lhr-solar/VCAT-BlackBody/hardware/BlackBodyBoard.csv

Reference | Qty | P/N | Value | DNP | Exclude from BOM | Exclude from Board | Exclude from Simulation | Exclude from Position Files | Footprint | Datasheet
C1 | 1 | 0603N270F500CT | 26p |  |  |  |  | ${EXCLUDE_FROM_POS_FILES} | Capacitor_SMD:C_0603_1608Metric_Pad1.08x0.95mm_HandSolder
C2 | 1 | 0603N270F500CT | 26p |  |  |  |  | ${EXCLUDE_FROM_POS_FILES} | Capacitor_SMD:C_0603_1608Metric_Pad1.08x0.95mm_HandSolder
C3 | 1 | MLASH168SB7104KTNA01 | 0.1u |  |  |  |  | ${EXCLUDE_FROM_POS_FILES} | Capacitor_SMD:C_0603_1608Metric_Pad1.08x0.95mm_HandSolder
C4 | 1 | GRM21BR61H106KE43K | 10u |  |  |  |  | ${EXCLUDE_FROM_POS_FILES} | Capacitor_SMD:C_0805_2012Metric
C5 | 1 | MLASH168SB7104KTNA01 | 0.1u |  |  |  |  | ${EXCLUDE_FROM_POS_FILES} | Capacitor_SMD:C_0603_1608Metric_Pad1.08x0.95mm_HandSolder
C6 | 1 | MLASH168SB7104KTNA01 | 0.1u |  |  |  |  | ${EXCLUDE_FROM_POS_FILES} | Capacitor_SMD:C_0603_1608Metric_Pad1.08x0.95mm_HandSolder
C7 | 1 | MLASH168SB7104KTNA01 | 0.1u |  |  |  |  | ${EXCLUDE_FROM_POS_FILES} | Capacitor_SMD:C_0603_1608Metric_Pad1.08x0.95mm_HandSolder
C8 | 1 | MLASH168SB7104KTNA01 | 0.1u |  |  |  |  | ${EXCLUDE_FROM_POS_FILES} | Capacitor_SMD:C_0603_1608Metric_Pad1.08x0.95mm_HandSolder
C9 | 1 | MLASU168SB5105KTNA01 | 1u |  |  |  |  | ${EXCLUDE_FROM_POS_FILES} | Capacitor_SMD:C_0603_1608Metric_Pad1.08x0.95mm_HandSolder
C10 | 1 | MLASH168SB7104KTNA01 | 0.1u |  |  |  |  | ${EXCLUDE_FROM_POS_FILES} | Capacitor_SMD:C_0603_1608Metric_Pad1.08x0.95mm_HandSolder
C11 | 1 | MLASU168SB5105KTNA01 | 1u |  |  |  |  | ${EXCLUDE_FROM_POS_FILES} | Capacitor_SMD:C_0603_1608Metric_Pad1.08x0.95mm_HandSolder
C12 | 1 | MLASH168SB7104KTNA01 | 0.1u |  |  |  |  | ${EXCLUDE_FROM_POS_FILES} | Capacitor_SMD:C_0603_1608Metric_Pad1.08x0.95mm_HandSolder
C13 | 1 | MLASH168SB7104KTNA01 | 0.1u |  |  |  |  | ${EXCLUDE_FROM_POS_FILES} | Capacitor_SMD:C_0603_1608Metric_Pad1.08x0.95mm_HandSolder
C14 | 1 | MLASH168SB7104KTNA01 | 0.1u |  |  |  |  | ${EXCLUDE_FROM_POS_FILES} | Capacitor_SMD:C_0603_1608Metric_Pad1.08x0.95mm_HandSolder
C15 | 1 | MLASH168SB7104KTNA01 | 100n |  |  |  |  | ${EXCLUDE_FROM_POS_FILES} | Capacitor_SMD:C_0603_1608Metric_Pad1.08x0.95mm_HandSolder
C16 | 1 | GRM21BR61H106KE43K | 10u |  |  |  |  | ${EXCLUDE_FROM_POS_FILES} | Capacitor_SMD:C_0805_2012Metric_Pad1.18x1.45mm_HandSolder
C17 | 1 | MLASH168SB7104KTNA01 | 0.1u |  |  |  |  | ${EXCLUDE_FROM_POS_FILES} | Capacitor_SMD:C_0603_1608Metric_Pad1.08x0.95mm_HandSolder
C18 | 1 | MLASH168SB7104KTNA01 | 0.1u |  |  |  |  | ${EXCLUDE_FROM_POS_FILES} | Capacitor_SMD:C_0603_1608Metric_Pad1.08x0.95mm_HandSolder
C19 | 1 | MLASH168SB7104KTNA01 | 0.1u |  |  |  |  | ${EXCLUDE_FROM_POS_FILES} | Capacitor_SMD:C_0603_1608Metric_Pad1.08x0.95mm_HandSolder
C23 | 1 | CL10B104KB8NNNC | 100n |  |  |  |  | ${EXCLUDE_FROM_POS_FILES} | Capacitor_SMD:C_0603_1608Metric_Pad1.08x0.95mm_HandSolder | ~
C24 | 1 | TMK212BBJ106MGHT | 10u |  |  |  |  | ${EXCLUDE_FROM_POS_FILES} | Capacitor_SMD:C_0805_2012Metric
C25 | 1 | CC0603KRX7R9BB105 | 1u |  |  |  |  | ${EXCLUDE_FROM_POS_FILES} | Capacitor_SMD:C_0603_1608Metric_Pad1.08x0.95mm_HandSolder | ~
C26 | 1 | CL10B104KB8NNNC | 100n |  |  |  |  | ${EXCLUDE_FROM_POS_FILES} | Capacitor_SMD:C_0603_1608Metric_Pad1.08x0.95mm_HandSolder | ~
C27 | 1 | CL10B104KB8NNNC | 100n |  |  |  |  | ${EXCLUDE_FROM_POS_FILES} | Capacitor_SMD:C_0603_1608Metric_Pad1.08x0.95mm_HandSolder | ~
C28 | 1 | CC0603KRX7R9BB103 | 10n |  |  |  |  | ${EXCLUDE_FROM_POS_FILES} | Capacitor_SMD:C_0603_1608Metric_Pad1.08x0.95mm_HandSolder | ~
C29 | 1 | CC0603KRX7R9BB103 | 10n |  |  |  |  | ${EXCLUDE_FROM_POS_FILES} | Capacitor_SMD:C_0603_1608Metric_Pad1.08x0.95mm_HandSolder | ~
C30 | 1 | CC0603KRX7R9BB103 | 10n |  |  |  |  | ${EXCLUDE_FROM_POS_FILES} | Capacitor_SMD:C_0603_1608Metric_Pad1.08x0.95mm_HandSolder | ~
C31 | 1 | CC0603KRX7R9BB103 | 10n |  |  |  |  | ${EXCLUDE_FROM_POS_FILES} | Capacitor_SMD:C_0603_1608Metric_Pad1.08x0.95mm_HandSolder | ~
C40 | 1 | 08055D475KAT4A | 4.7u |  |  |  |  | ${EXCLUDE_FROM_POS_FILES} | Capacitor_SMD:C_0805_2012Metric_Pad1.18x1.45mm_HandSolder
C41 | 1 | MLASH168SB7104KTNA01 | 100n |  |  |  |  | ${EXCLUDE_FROM_POS_FILES} | Capacitor_SMD:C_0603_1608Metric_Pad1.08x0.95mm_HandSolder
C42 | 1 | MLASH168SB7104KTNA01 | 100n |  |  |  |  | ${EXCLUDE_FROM_POS_FILES} | Capacitor_SMD:C_0603_1608Metric
C43 | 1 | GMK325BJ226MM-P | 22u |  |  |  |  | ${EXCLUDE_FROM_POS_FILES} | Capacitor_SMD:C_1210_3225Metric_Pad1.33x2.70mm_HandSolder
C44 | 1 | GMK325BJ226MM-P | 22u |  |  |  |  | ${EXCLUDE_FROM_POS_FILES} | Capacitor_SMD:C_1210_3225Metric_Pad1.33x2.70mm_HandSolder
C45 | 1 | C2012X5R1H335K125AB | 3.3u |  |  |  |  | ${EXCLUDE_FROM_POS_FILES} | Capacitor_SMD:C_0805_2012Metric_Pad1.18x1.45mm_HandSolder
C46 | 1 | GRM21BR61H106KE43K | 10u |  |  |  |  | ${EXCLUDE_FROM_POS_FILES} | Capacitor_SMD:C_0805_2012Metric_Pad1.18x1.45mm_HandSolder
C47 | 1 | GRM21BR61H106KE43K | 10u |  |  |  |  | ${EXCLUDE_FROM_POS_FILES} | Capacitor_SMD:C_0805_2012Metric_Pad1.18x1.45mm_HandSolder
C48 | 1 | CL10B104KB8NNNC | 0.1u |  |  |  |  | ${EXCLUDE_FROM_POS_FILES} | Capacitor_SMD:C_0603_1608Metric_Pad1.08x0.95mm_HandSolder
C49 | 1 | CC0603KRX7R9BB105 | 1u |  |  |  |  | ${EXCLUDE_FROM_POS_FILES} | Capacitor_SMD:C_0603_1608Metric_Pad1.08x0.95mm_HandSolder
C50 | 1 | CC0603KRX7R9BB224 | 220n |  |  |  |  | ${EXCLUDE_FROM_POS_FILES} | Capacitor_SMD:C_0603_1608Metric_Pad1.08x0.95mm_HandSolder
C51 | 1 | CC0603KRX7R9BB103 | 10n |  |  |  |  | ${EXCLUDE_FROM_POS_FILES} | Capacitor_SMD:C_0603_1608Metric_Pad1.08x0.95mm_HandSolder
C52 | 1 | GRM21BR61H106KE43L | 10u |  |  |  |  | ${EXCLUDE_FROM_POS_FILES} | Capacitor_SMD:C_0805_2012Metric_Pad1.18x1.45mm_HandSolder
C53 | 1 | CL10B104KB8NNNC | 0.1u |  |  |  |  | ${EXCLUDE_FROM_POS_FILES} | Capacitor_SMD:C_0603_1608Metric_Pad1.08x0.95mm_HandSolder
C54 | 1 | CL10B104KB8NNNC | 0.1u |  |  |  |  | ${EXCLUDE_FROM_POS_FILES} | Capacitor_SMD:C_0603_1608Metric_Pad1.08x0.95mm_HandSolder
C55 | 1 | MLASH168SB7104KTNA01 | 0.1u |  |  |  |  | ${EXCLUDE_FROM_POS_FILES} | Capacitor_SMD:C_0603_1608Metric_Pad1.08x0.95mm_HandSolder
C56 | 1 | MLASH168SB7104KTNA01 | 0.1u |  |  |  |  | ${EXCLUDE_FROM_POS_FILES} | Capacitor_SMD:C_0603_1608Metric_Pad1.08x0.95mm_HandSolder
C57 | 1 | MLASH168SB7104KTNA01 | 0.1u |  |  |  |  | ${EXCLUDE_FROM_POS_FILES} | Capacitor_SMD:C_0603_1608Metric_Pad1.08x0.95mm_HandSolder
C58 | 1 | MLASH168SB7104KTNA01 | 0.1u |  |  |  |  | ${EXCLUDE_FROM_POS_FILES} | Capacitor_SMD:C_0603_1608Metric_Pad1.08x0.95mm_HandSolder
C59 | 1 | MLASU168SB5105KTNA01 | 10u |  |  |  |  | ${EXCLUDE_FROM_POS_FILES} | Capacitor_SMD:C_0603_1608Metric_Pad1.08x0.95mm_HandSolder
D1 | 1 | 19-337/R6GHBHC-A01/2T | RGB_LED |  |  |  |  | ${EXCLUDE_FROM_POS_FILES} | LHRS_Special:RGB_LED | kicad-embed://EVER-S-A0007433884-1.pdf
D2 | 1 | PESD15VL1BA | TVS |  |  |  |  | ${EXCLUDE_FROM_POS_FILES} | Diode_SMD:D_SOD-323 | kicad-embed://TVS.pdf
D3 | 1 | LTST-C193TBKT-5A | LED |  |  |  |  | ${EXCLUDE_FROM_POS_FILES} | LED_SMD:LED_0603_1608Metric | kicad-embed://Blue LED.pdf
D4 | 1 | CDSOT23-T24CAN | CDSOT23-T24CAN |  |  |  |  | ${EXCLUDE_FROM_POS_FILES} | LHRS_Passives:CDSOT23-T24CAN | kicad-embed://cdsot23-t24can.pdf
D5 | 1 | D5V0P4UR6SO-7 | D5V0P4UR6SO-7 |  |  |  |  | ${EXCLUDE_FROM_POS_FILES} | LHRS_ICs:D5V0P4UR6SO-7 | https://www.diodes.com/assets/Datasheets/D5V0P4UR6SO.pdf
D6 | 1 | SP0503BAHTG | SP0503BAHT |  |  |  |  | ${EXCLUDE_FROM_POS_FILES} | Package_TO_SOT_SMD:SOT-143 | http://www.littelfuse.com/~/media/files/littelfuse/technical%20resources/documents/data%20sheets/sp05xxba.pdf
D7 | 1 | BAT760-7 | D_Schottky |  |  |  |  | ${EXCLUDE_FROM_POS_FILES} | Diode_SMD:D_SOD-123
D9 | 1 | D5V0P4UR6SO-7 | D5V0P4UR6SO-7 |  |  |  |  | ${EXCLUDE_FROM_POS_FILES} | LHRS_ICs:D5V0P4UR6SO-7 | https://www.diodes.com/assets/Datasheets/D5V0P4UR6SO.pdf
D10 | 1 | SBA130CH-AU_R1_000A1 | SBA130CH-AU_R1_000A1 |  |  |  |  | ${EXCLUDE_FROM_POS_FILES} | Diode_SMD:D_SOD-323_HandSoldering | https://www.mouser.com/datasheet/3/3736/1/11145663EF9055F8C188C22CC003165FC5A818A8439A953D3A6E1D8FCBF51DA1.pdf
D11 | 1 | SMBJ15CA | SMBJ15CA |  |  |  |  | ${EXCLUDE_FROM_POS_FILES} | Diode_SMD:D_SMB | kicad-embed://SMBJ15CA.pdf
D12 | 1 | SMAF4758A | SMAF4758A |  |  |  |  | ${EXCLUDE_FROM_POS_FILES} | LHRS_Passives:SODFL5026X125N | kicad-embed://SMAF4758A.pdf
D13 | 1 | LTST-C193TBKT-5A | LED |  |  |  |  | ${EXCLUDE_FROM_POS_FILES} | LED_SMD:LED_0603_1608Metric | kicad-embed://Blue LED.pdf
D14 | 1 | LTST-C193TBKT-5A | LED |  |  |  |  | ${EXCLUDE_FROM_POS_FILES} | LED_SMD:LED_0603_1608Metric | kicad-embed://Blue LED.pdf
D15 | 1 | LTST-C193TBKT-5A | LED |  |  |  |  | ${EXCLUDE_FROM_POS_FILES} | LED_SMD:LED_0603_1608Metric | kicad-embed://Blue LED.pdf
F2 | 1 | 3557-2 | Fuse |  |  |  |  | ${EXCLUDE_FROM_POS_FILES} | LHRS_Power:Fuse-3557-2
FB1 | 1 | BLM18PG121SH1D | FerriteBead |  |  |  |  | ${EXCLUDE_FROM_POS_FILES} | Capacitor_SMD:C_0603_1608Metric_Pad1.08x0.95mm_HandSolder | kicad-embed://FerriteBead.pdf
FB2 | 1 | BLM18PG121SH1D | FerriteBead |  |  |  |  | ${EXCLUDE_FROM_POS_FILES} | Capacitor_SMD:C_0603_1608Metric_Pad1.08x0.95mm_HandSolder | kicad-embed://FerriteBead.pdf
IC1 | 1 | TCAN3413DR | TCAN3413DR |  |  |  |  | ${EXCLUDE_FROM_POS_FILES} | LHRS_Passives:TCAN3413DR | kicad-embed://tcan3413.pdf
IC3 | 1 | LM74502DDFR | LM74502DDFR |  |  |  |  | ${EXCLUDE_FROM_POS_FILES} | LHRS_Power:LM74502DDFR | kicad-embed://LM74502DDFR.pdf
J1 | 1 | 0878320406 | SWD_Header |  |  |  |  | ${EXCLUDE_FROM_POS_FILES} | LHRS_Connectors:SWD_Conn | kicad-embed://Conn_02x02_Odd_Even.pdf
J2 | 1 |  | SWD |  |  |  |  | ${EXCLUDE_FROM_POS_FILES} | Connector_PinHeader_2.54mm:PinHeader_1x04_P2.54mm_Vertical
J3 | 1 | USB4105-GF-A | USB_C_Receptacle_USB2.0_16P |  |  |  |  | ${EXCLUDE_FROM_POS_FILES} | LHRS_Connectors:USB_C_Receptacle_GCT_USB4105-xx-A_16P_TopMnt_Horizontal | https://www.usb.org/sites/default/files/documents/usb_type-c.zip
J4 | 1 | 1053131105 | Nano-Fit 1x5 |  |  |  |  | ${EXCLUDE_FROM_POS_FILES} | LHRS_Connectors:Molex_Nano-Fit_105309-xx05_1x05_P2.50mm_Vertical | ~
J5 | 1 | 1053132102 | TC K-type |  |  |  |  | ${EXCLUDE_FROM_POS_FILES} | LHRS_Connectors:Molex_Nano-Fit_105309-xx02_1x02_P2.50mm_Vertical | ~
J6 | 1 | 1053091104 | CAN_DEBUG |  |  |  |  | ${EXCLUDE_FROM_POS_FILES} | LHRS_Connectors:Molex_Nano-Fit_105309-xx04_1x04_P2.50mm_Vertical
J7 | 1 | 1053091105 | CAN_IN |  |  |  |  | ${EXCLUDE_FROM_POS_FILES} | LHRS_Connectors:Molex_Nano-Fit_105309-xx05_1x05_P2.50mm_Vertical
J8 | 1 | 1053132102 | TC K-type |  |  |  |  | ${EXCLUDE_FROM_POS_FILES} | LHRS_Connectors:Molex_Nano-Fit_105309-xx02_1x02_P2.50mm_Vertical | ~
J10 | 1 |  | SPI |  |  |  |  | ${EXCLUDE_FROM_POS_FILES} | Connector_PinHeader_2.54mm:PinHeader_1x06_P2.54mm_Vertical
J11 | 1 | 1053091105 | CAN_OUT |  |  |  |  | ${EXCLUDE_FROM_POS_FILES} | LHRS_Connectors:Molex_Nano-Fit_105309-xx05_1x05_P2.50mm_Vertical
JP1 | 1 |  | TRM |  |  |  |  | ${EXCLUDE_FROM_POS_FILES} | Connector_PinHeader_2.54mm:PinHeader_1x02_P2.54mm_Vertical
L2 | 1 | 74439369082 | 8.2u |  |  |  |  | ${EXCLUDE_FROM_POS_FILES} | LHRS_Passives:74439369082
Q3 | 1 | PSMN012-100YSFX | PSMN012-100YS |  |  |  |  | ${EXCLUDE_FROM_POS_FILES} | Package_TO_SOT_SMD:LFPAK56 | kicad-embed://PSMN012-100YS.pdf
Q4 | 1 | PSMN012-100YSFX | PSMN012-100YS |  |  |  |  | ${EXCLUDE_FROM_POS_FILES} | Package_TO_SOT_SMD:LFPAK56 | kicad-embed://PSMN012-100YS.pdf
R1 | 1 | CRCW06031K00FKEI | 1k |  |  |  |  | ${EXCLUDE_FROM_POS_FILES} | Resistor_SMD:R_0603_1608Metric_Pad0.98x0.95mm_HandSolder
R2 | 1 | CRCW060310K0FKEI | 10k |  |  |  |  | ${EXCLUDE_FROM_POS_FILES} | Resistor_SMD:R_0603_1608Metric_Pad0.98x0.95mm_HandSolder
R3 | 1 | CRCW06031K00FKEI | 1k |  |  |  |  | ${EXCLUDE_FROM_POS_FILES} | Resistor_SMD:R_0603_1608Metric_Pad0.98x0.95mm_HandSolder
R4 | 1 | CRCW06031K00FKEI | 1k |  |  |  |  | ${EXCLUDE_FROM_POS_FILES} | Resistor_SMD:R_0603_1608Metric_Pad0.98x0.95mm_HandSolder
R5 | 1 | FRC0603F22R0TS | 22 |  |  |  |  | ${EXCLUDE_FROM_POS_FILES} | Resistor_SMD:R_0603_1608Metric_Pad0.98x0.95mm_HandSolder
R6 | 1 | FRC0603F22R0TS | 22 |  |  |  |  | ${EXCLUDE_FROM_POS_FILES} | Resistor_SMD:R_0603_1608Metric_Pad0.98x0.95mm_HandSolder
R7 | 1 | CRCW060310K0FKEI | 10k |  |  |  |  | ${EXCLUDE_FROM_POS_FILES} | Resistor_SMD:R_0603_1608Metric_Pad0.98x0.95mm_HandSolder
R8 | 1 | CRCW06031K00FKEI | 1k |  |  |  |  | ${EXCLUDE_FROM_POS_FILES} | Resistor_SMD:R_0603_1608Metric_Pad0.98x0.95mm_HandSolder
R9 | 1 | CRCW060360R4FKEA | 60 |  |  |  |  | ${EXCLUDE_FROM_POS_FILES} | Resistor_SMD:R_0603_1608Metric_Pad0.98x0.95mm_HandSolder
R10 | 1 | CRCW060360R4FKEA | 60 |  |  |  |  | ${EXCLUDE_FROM_POS_FILES} | Resistor_SMD:R_0603_1608Metric_Pad0.98x0.95mm_HandSolder
R11 | 1 | 0603WAF5101T5E | 5.1k |  |  |  |  | ${EXCLUDE_FROM_POS_FILES} | Resistor_SMD:R_0603_1608Metric_Pad0.98x0.95mm_HandSolder
R12 | 1 | 0603WAF5101T5E | 5.1k |  |  |  |  | ${EXCLUDE_FROM_POS_FILES} | Resistor_SMD:R_0603_1608Metric_Pad0.98x0.95mm_HandSolder
R21 | 1 | 0603WAF1002T5E | 10k |  |  |  |  | ${EXCLUDE_FROM_POS_FILES} | Resistor_SMD:R_0603_1608Metric_Pad0.98x0.95mm_HandSolder | ~
R22 | 1 | CRCW0603100KFKEE | 100k |  |  |  |  | ${EXCLUDE_FROM_POS_FILES} | Resistor_SMD:R_0603_1608Metric
R23 | 1 | CRCW060319K1FKEAHP | 19.1k |  |  |  |  | ${EXCLUDE_FROM_POS_FILES} | Resistor_SMD:R_0603_1608Metric
R24 | 1 | 0603WAF1002T5E | 10k |  |  |  |  | ${EXCLUDE_FROM_POS_FILES} | Resistor_SMD:R_0603_1608Metric_Pad0.98x0.95mm_HandSolder
R25 | 1 | MCT06030C3309FP500 | 33 |  |  |  |  | ${EXCLUDE_FROM_POS_FILES} | Resistor_SMD:R_0603_1608Metric_Pad0.98x0.95mm_HandSolder
R26 | 1 | 0603WAF1003T5E | 100k |  |  |  |  | ${EXCLUDE_FROM_POS_FILES} | Resistor_SMD:R_0603_1608Metric_Pad0.98x0.95mm_HandSolder
R27 | 1 | RT0603BRE077K32L | 7.32k |  |  |  |  | ${EXCLUDE_FROM_POS_FILES} | Resistor_SMD:R_0603_1608Metric_Pad0.98x0.95mm_HandSolder
R28 | 1 | 0603WAF1003T5E | 100k |  |  |  |  | ${EXCLUDE_FROM_POS_FILES} | Resistor_SMD:R_0603_1608Metric_Pad0.98x0.95mm_HandSolder
R29 | 1 | 0603WAF1001T5E | 1k |  |  |  |  | ${EXCLUDE_FROM_POS_FILES} | Resistor_SMD:R_0603_1608Metric_Pad0.98x0.95mm_HandSolder
R30 | 1 | 0603WAF1001T5E | 1k |  |  |  |  | ${EXCLUDE_FROM_POS_FILES} | Resistor_SMD:R_0603_1608Metric_Pad0.98x0.95mm_HandSolder
R31 | 1 | 0603WAF1001T5E | 1k |  |  |  |  | ${EXCLUDE_FROM_POS_FILES} | Resistor_SMD:R_0603_1608Metric_Pad0.98x0.95mm_HandSolder
R32 | 1 | CRCW060315K8FKEA | 15.8k |  |  |  |  | ${EXCLUDE_FROM_POS_FILES} | Resistor_SMD:R_0603_1608Metric_Pad0.98x0.95mm_HandSolder
R33 | 1 | CRCW060310K0FKEI | 10k |  |  |  |  | ${EXCLUDE_FROM_POS_FILES} | Resistor_SMD:R_0603_1608Metric_Pad0.98x0.95mm_HandSolder
R34 | 1 | 0603WAF1004T5E | 1M |  |  |  |  | ${EXCLUDE_FROM_POS_FILES} | Resistor_SMD:R_0603_1608Metric_Pad0.98x0.95mm_HandSolder | ~
R35 | 1 | 0603WAF1004T5E | 1M |  |  |  |  | ${EXCLUDE_FROM_POS_FILES} | Resistor_SMD:R_0603_1608Metric_Pad0.98x0.95mm_HandSolder | ~
R36 | 1 | 0603WAF1004T5E | 1M |  |  |  |  | ${EXCLUDE_FROM_POS_FILES} | Resistor_SMD:R_0603_1608Metric_Pad0.98x0.95mm_HandSolder | ~
R37 | 1 | 0603WAF1004T5E | 1M |  |  |  |  | ${EXCLUDE_FROM_POS_FILES} | Resistor_SMD:R_0603_1608Metric_Pad0.98x0.95mm_HandSolder | ~
R38 | 1 | 0603WAF1001T5E | 1k |  |  |  |  | ${EXCLUDE_FROM_POS_FILES} | Resistor_SMD:R_0603_1608Metric_Pad0.98x0.95mm_HandSolder | ~
R39 | 1 | 0603WAF1001T5E | 1k |  |  |  |  | ${EXCLUDE_FROM_POS_FILES} | Resistor_SMD:R_0603_1608Metric_Pad0.98x0.95mm_HandSolder | ~
R40 | 1 | 0603WAF1001T5E | 1k |  |  |  |  | ${EXCLUDE_FROM_POS_FILES} | Resistor_SMD:R_0603_1608Metric_Pad0.98x0.95mm_HandSolder | ~
R41 | 1 | FRC0603F22R0TS | 22 |  |  |  |  | ${EXCLUDE_FROM_POS_FILES} | Resistor_SMD:R_0603_1608Metric_Pad0.98x0.95mm_HandSolder
R42 | 1 | FRC0603F22R0TS | 22 |  |  |  |  | ${EXCLUDE_FROM_POS_FILES} | Resistor_SMD:R_0603_1608Metric_Pad0.98x0.95mm_HandSolder
R43 | 1 | 0603WAF1001T5E | 1k |  |  |  |  | ${EXCLUDE_FROM_POS_FILES} | Resistor_SMD:R_0603_1608Metric_Pad0.98x0.95mm_HandSolder | ~
R48 | 1 | FRC0603F22R0TS | 22 |  |  |  |  | ${EXCLUDE_FROM_POS_FILES} | Resistor_SMD:R_0603_1608Metric_Pad0.98x0.95mm_HandSolder
R61 | 1 | CRCW06030000Z0EE | 0 | DNP |  |  |  | ${EXCLUDE_FROM_POS_FILES} | Resistor_SMD:R_0603_1608Metric_Pad0.98x0.95mm_HandSolder
R66 | 1 | 0603WAF1602T5E | 16k |  |  |  |  | ${EXCLUDE_FROM_POS_FILES} | Resistor_SMD:R_0603_1608Metric_Pad0.98x0.95mm_HandSolder
R67 | 1 | 0603WAF4701T5E | 4.7k |  |  |  |  | ${EXCLUDE_FROM_POS_FILES} | Resistor_SMD:R_0603_1608Metric_Pad0.98x0.95mm_HandSolder
SW1 | 1 | TL3365AF180QG | Reset |  |  |  |  | ${EXCLUDE_FROM_POS_FILES} | LHRS_Special:TL3365AF180QG | kicad-embed://ResetBtn.pdf
SW2 | 1 | 450406020024 | SW_SPDT |  |  |  |  | ${EXCLUDE_FROM_POS_FILES} | LHRS_Special:BootSW | kicad-embed://BootSW.pdf
TP6 | 1 |  | TC_ADC_CS |  |  |  |  | ${EXCLUDE_FROM_POS_FILES} | Connector_PinHeader_2.54mm:PinHeader_1x01_P2.54mm_Vertical | ~
TP7 | 1 |  | TCP |  |  |  |  | ${EXCLUDE_FROM_POS_FILES} | Connector_PinHeader_2.54mm:PinHeader_1x01_P2.54mm_Vertical | ~
TP8 | 1 |  | TCP |  |  |  |  | ${EXCLUDE_FROM_POS_FILES} | Connector_PinHeader_2.54mm:PinHeader_1x01_P2.54mm_Vertical | ~
TP10 | 1 |  | TCN |  |  |  |  | ${EXCLUDE_FROM_POS_FILES} | Connector_PinHeader_2.54mm:PinHeader_1x01_P2.54mm_Vertical | ~
TP11 | 1 |  | TCN |  |  |  |  | ${EXCLUDE_FROM_POS_FILES} | Connector_PinHeader_2.54mm:PinHeader_1x01_P2.54mm_Vertical | ~
TP38 | 1 |  | +12V |  |  |  |  | ${EXCLUDE_FROM_POS_FILES} | Connector_PinHeader_2.54mm:PinHeader_1x01_P2.54mm_Vertical
TP39 | 1 |  | +12V_PP |  |  |  |  | ${EXCLUDE_FROM_POS_FILES} | Connector_PinHeader_2.54mm:PinHeader_1x01_P2.54mm_Vertical
TP40 | 1 |  | +5V_BUCK |  |  |  |  | ${EXCLUDE_FROM_POS_FILES} | Connector_PinHeader_2.54mm:PinHeader_1x01_P2.54mm_Vertical
TP41 | 1 |  | +USBC_5V |  |  |  |  | ${EXCLUDE_FROM_POS_FILES} | Connector_PinHeader_2.54mm:PinHeader_1x01_P2.54mm_Vertical
TP42 | 1 |  | MUX_OUT |  |  |  |  | ${EXCLUDE_FROM_POS_FILES} | Connector_PinHeader_2.54mm:PinHeader_1x01_P2.54mm_Vertical
TP44 | 1 |  | Power TestPoint |  |  |  |  | ${EXCLUDE_FROM_POS_FILES} | Connector_PinHeader_2.54mm:PinHeader_1x01_P2.54mm_Vertical
TP45 | 1 |  | MCU TestPoint |  |  |  |  | ${EXCLUDE_FROM_POS_FILES} | Connector_PinHeader_2.54mm:PinHeader_1x01_P2.54mm_Vertical
TP46 | 1 |  | CAN TestPoint |  |  |  |  | ${EXCLUDE_FROM_POS_FILES} | Connector_PinHeader_2.54mm:PinHeader_1x01_P2.54mm_Vertical
U1 | 1 | STM32G473CET6 | STM32G473CETx |  |  |  |  | ${EXCLUDE_FROM_POS_FILES} | LHRS_Special:48PinMCU | kicad-embed://stm32g473cb.pdf
U3 | 1 | ADS1118IDGSR | ADS1118IDGS |  |  |  |  | ${EXCLUDE_FROM_POS_FILES} | Package_SO:TSSOP-10_3x3mm_P0.5mm | https://www.ti.com/lit/ds/symlink/ads1118.pdf
U5 | 1 | LMR51635XDDCR | LMR51635XDDCR |  |  |  |  | ${EXCLUDE_FROM_POS_FILES} | LHRS_ICs:DDC0006A-MFG | kicad-embed://lmr51635.pdf
U6 | 1 | MCP1826S-3302E/DB | MCP1826S |  |  |  |  | ${EXCLUDE_FROM_POS_FILES} | Package_TO_SOT_SMD:SOT-223-3_TabPin2 | http://ww1.microchip.com/downloads/en/DeviceDoc/22057B.pdf
U7 | 1 | TPS2117DRLR | TPS2117DRLR |  |  |  |  | ${EXCLUDE_FROM_POS_FILES} | LHRS_Power:TPS2117DRLR | kicad-embed://tps2117-datasheet.pdf
Y1 | 1 | ABM3-8.000MHZ-D2Y-T | Crystal |  |  |  |  | ${EXCLUDE_FROM_POS_FILES} | LHRS_Passives:Crystal_SMD_Abracon_ABM3-2Pin_5.0x3.2mm | kicad-embed://HSE_Crystal.pdf
