lhr-solar/VCAT-BlackBody/hardware/BlackBodyBoard.kicad_pcb

## KiCad design hardware/BlackBodyBoard.kicad_pcb (2026-11-10)

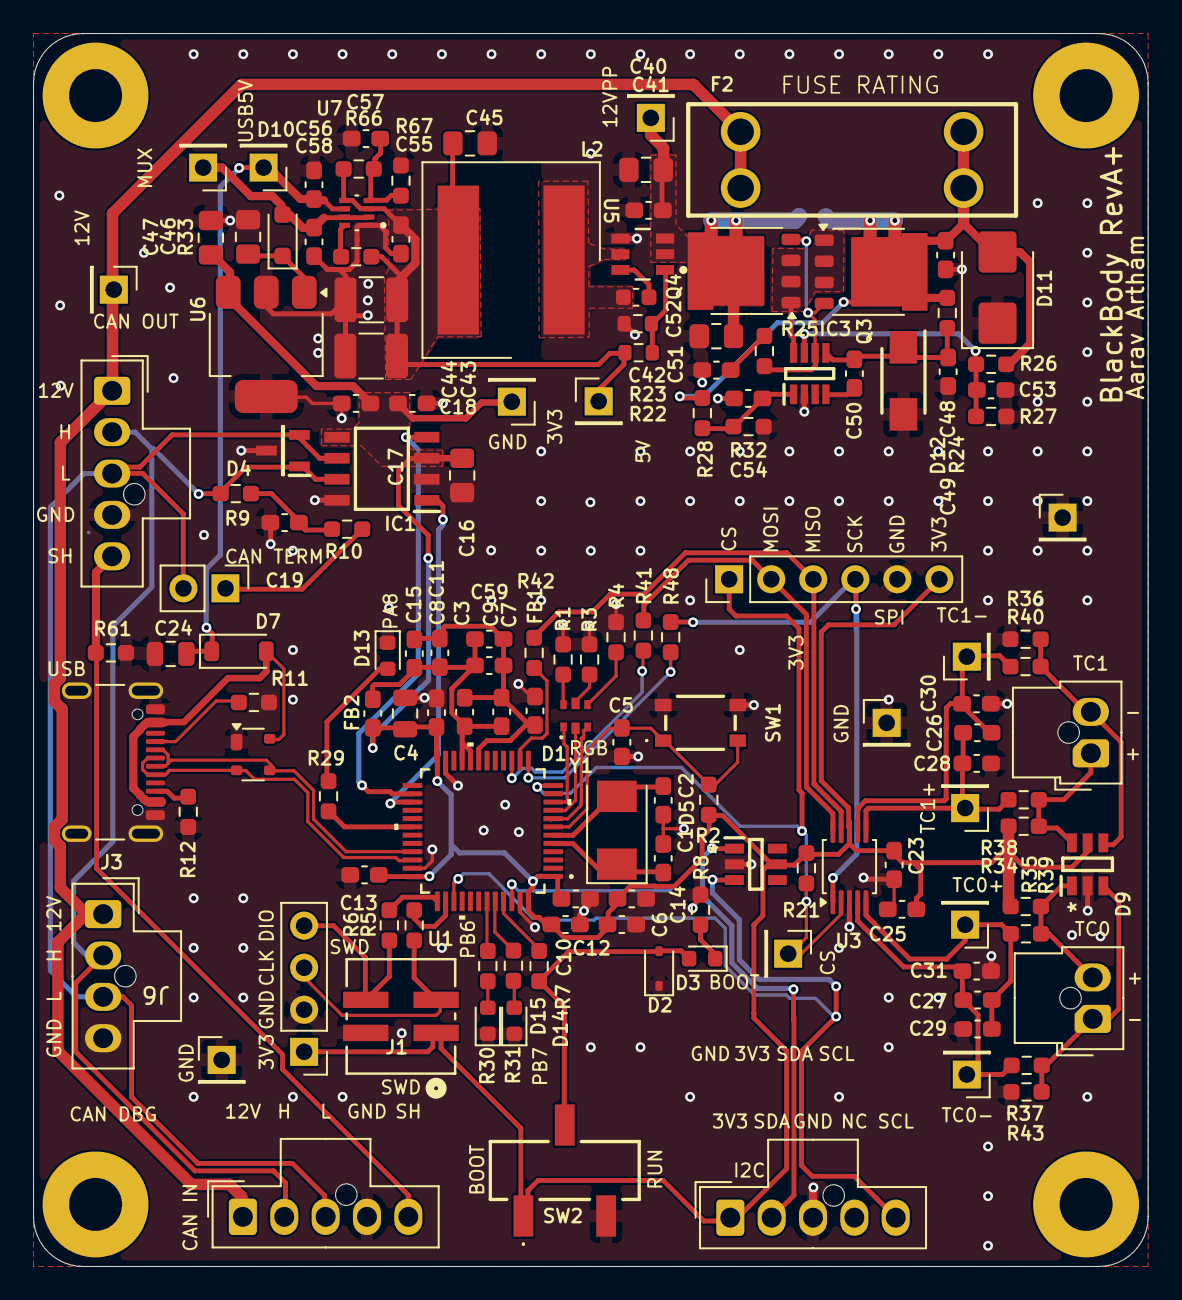
[picture p1: board BlackBodyBoard.kicad_pcb from above]

Board: 2 copper layers, 67.3 x 74.5 mm, 147 parts (1 on the bottom side), 74 nets.

Parts:
C1, C2: 26p; C_0603_1608Metric_Pad1.08x0.95mm_HandSolder
C3, C5, C6, C7, C8, C10, C12, C13, C14, C17, C18, C19, C48, C53, C54, C55, C56, C57, C58: 0.1u; C_0603_1608Metric_Pad1.08x0.95mm_HandSolder
C4, C24: 10u; C_0805_2012Metric
C9, C11, C25, C49: 1u; C_0603_1608Metric_Pad1.08x0.95mm_HandSolder
C15, C23, C26, C27, C41: 100n; C_0603_1608Metric_Pad1.08x0.95mm_HandSolder
C16, C46, C47, C52: 10u; C_0805_2012Metric_Pad1.18x1.45mm_HandSolder
C28, C29, C30, C31, C51: 10n; C_0603_1608Metric_Pad1.08x0.95mm_HandSolder
C40: 4.7u; C_0805_2012Metric_Pad1.18x1.45mm_HandSolder
C42: 100n; C_0603_1608Metric
C43, C44: 22u; C_1210_3225Metric_Pad1.33x2.70mm_HandSolder
C45: 3.3u; C_0805_2012Metric_Pad1.18x1.45mm_HandSolder
C50: 220n; C_0603_1608Metric_Pad1.08x0.95mm_HandSolder
C59: 10u; C_0603_1608Metric_Pad1.08x0.95mm_HandSolder
D1: RGB_LED
D2: TVS; D_SOD-323
D3, D13, D14, D15: LED; LED_0603_1608Metric
D4: CDSOT23-T24CAN
D5, D9: D5V0P4UR6SO-7
D6: SP0503BAHT; SOT-143
D7: D_Schottky; D_SOD-123
D10: SBA130CH-AU_R1_000A1; D_SOD-323_HandSoldering
D11: SMBJ15CA; D_SMB
D12: SMAF4758A; SODFL5026X125N
F2: Fuse; Fuse-3557-2
FB1, FB2: FerriteBead; C_0603_1608Metric_Pad1.08x0.95mm_HandSolder
H1, H2, H3, H4: MountingHole_3.2mm_M3_Pad
IC1: TCAN3413DR
IC3: LM74502DDFR
J1: SWD_Header; SWD_Conn
J2: SWD; PinHeader_1x04_P2.54mm_Vertical
J3: USB_C_Receptacle_USB2.0_16P; USB_C_Receptacle_GCT_USB4105-xx-A_16P_TopMnt_Horizontal
J4: Nano-Fit 1x5; Molex_Nano-Fit_105309-xx05_1x05_P2.50mm_Vertical
J5, J8: TC K-type; Molex_Nano-Fit_105309-xx02_1x02_P2.50mm_Vertical
J6: CAN_DEBUG; Molex_Nano-Fit_105309-xx04_1x04_P2.50mm_Vertical
J7: CAN_IN; Molex_Nano-Fit_105309-xx05_1x05_P2.50mm_Vertical
J10: SPI; PinHeader_1x06_P2.54mm_Vertical
J11: CAN_OUT; Molex_Nano-Fit_105309-xx05_1x05_P2.50mm_Vertical
JP1: TRM; PinHeader_1x02_P2.54mm_Vertical
JP3: SolderJumper_2_Open; SolderJumper-2_P1.3mm_Open_RoundedPad1.0x1.5mm
L2: 8.2u; 74439369082
Q3, Q4: PSMN012-100YS; LFPAK56
R1, R3, R4, R8, R29, R30, R31, R38, R39, R40, R43: 1k; R_0603_1608Metric_Pad0.98x0.95mm_HandSolder
R2, R7, R21, R24, R33: 10k; R_0603_1608Metric_Pad0.98x0.95mm_HandSolder
R5, R6, R41, R42, R48: 22; R_0603_1608Metric_Pad0.98x0.95mm_HandSolder
R9, R10: 60; R_0603_1608Metric_Pad0.98x0.95mm_HandSolder
R11, R12: 5.1k; R_0603_1608Metric_Pad0.98x0.95mm_HandSolder
R22: 100k; R_0603_1608Metric
R23: 19.1k; R_0603_1608Metric
R25: 33; R_0603_1608Metric_Pad0.98x0.95mm_HandSolder
R26, R28: 100k; R_0603_1608Metric_Pad0.98x0.95mm_HandSolder
R27: 7.32k; R_0603_1608Metric_Pad0.98x0.95mm_HandSolder
R32: 15.8k; R_0603_1608Metric_Pad0.98x0.95mm_HandSolder
R34, R35, R36, R37: 1M; R_0603_1608Metric_Pad0.98x0.95mm_HandSolder
R61: 0; R_0603_1608Metric_Pad0.98x0.95mm_HandSolder
R66: 16k; R_0603_1608Metric_Pad0.98x0.95mm_HandSolder
R67: 4.7k; R_0603_1608Metric_Pad0.98x0.95mm_HandSolder
SW1: Reset; TL3365AF180QG
SW2: SW_SPDT; BootSW
TP6: TC_ADC_CS; PinHeader_1x01_P2.54mm_Vertical
TP7, TP8: TCP; PinHeader_1x01_P2.54mm_Vertical
TP10, TP11: TCN; PinHeader_1x01_P2.54mm_Vertical
TP38: +12V; PinHeader_1x01_P2.54mm_Vertical
TP39: +12V_PP; PinHeader_1x01_P2.54mm_Vertical
TP40: +5V_BUCK; PinHeader_1x01_P2.54mm_Vertical
TP41: +USBC_5V; PinHeader_1x01_P2.54mm_Vertical
TP42: MUX_OUT; PinHeader_1x01_P2.54mm_Vertical
TP44: Power TestPoint; PinHeader_1x01_P2.54mm_Vertical
TP45: MCU TestPoint; PinHeader_1x01_P2.54mm_Vertical
TP46: CAN TestPoint; PinHeader_1x01_P2.54mm_Vertical
TP_3.3V2: 3.3V; PinHeader_1x01_P2.54mm_Vertical
U1: STM32G473CETx; 48PinMCU
U3: ADS1118IDGS; TSSOP-10_3x3mm_P0.5mm
U5: LMR51635XDDCR; DDC0006A-MFG
U6: MCP1826S; SOT-223-3_TabPin2
U7: TPS2117DRLR
Y1: Crystal; Crystal_SMD_Abracon_ABM3-2Pin_5.0x3.2mm

Connections:
+3.3V: C4.1, C6.1, C8.1, C10.1, C12.1, C13.1, C14.1, C16.1, C17.1, C18.1, C23.1, C25.1, C47.2, D5.5, D9.5, FB2.1, IC1.3 (VCC), IC1.5 (SHDNV_IO), J1.1, J2.1, J4.1, J10.6, R2.2, R21.1, R34.1, R35.1, SW2.1 (A), TP_3.3V2.1 (1_1), U1.1 (VBAT), U1.24 (VDD), U1.36 (VDD), U1.48 (VDD), U3.8 (VDD), U6.3 (VO)
+12V: F2.1, J6.1 (12V), J7.1 (12V), J11.1 (12V), TP38.1 (1_1)
/12VBuck1/CB: C42.1, U5.6 (CB)
/12VBuck1/FB: R22.2, R23.1, U5.1 (FB)
/12VBuck1/SW: C42.2, L2.1, U5.5 (SW)
/48PinMCU/BOOT0: R7.1, U1.45 (PB8-BOOT0)
/48PinMCU/NRST: C5.1, R2.1, SW1.1, U1.7 (PG10-NRST)
/48PinMCU/PA0: D1.5, U1.8 (PA0-GPIO_BLUE)
/48PinMCU/PA1: D1.3, U1.9 (PA1_GPIO_RED)
/48PinMCU/PA2: D1.1, U1.10 (PA2-GPIO_GREEN)
/48PinMCU/PA5: R48.1, U1.13 (PA5)
/48PinMCU/PA6: R42.1, U1.14 (PA6)
/48PinMCU/PA7: R41.1, U1.15 (PA7)
/48PinMCU/PA8: R29.1, U1.30 (PA8)
/48PinMCU/PB6: R30.1, U1.43 (PB6)
/48PinMCU/PB7: R31.1, U1.44 (PB7)
/48PinMCU/SWCLK: R5.1, U1.38 (PA14)
/48PinMCU/SWDIO: R6.1, U1.37 (PA13)
/48PinMCU/USB_DM: D6.3 (K), J3.A7 (D-), J3.B7 (D-), U1.33 (PA11)
/48PinMCU/USB_DP: D6.2 (K), J3.A6 (D+), J3.B6 (D+), U1.34 (PA12)
/48PinMCU/VDDA: C3.1, C7.1, C9.1, C11.1, C15.1, C59.1, FB2.2, U1.20 (VREF+), U1.21 (VDDA)
/+5V_BUCK: C43.1, C44.1, C45.1, C55.1, L2.2, R22.1, R33.1, R66.1, TP40.1 (1_1), U7.3 (VIN1), U7.5 (MODE)
/+12V_PP: C40.1, C41.1, C52.1, JP3.2 (B), Q4.5, TP39.1 (1_1), U5.2 (EN), U5.3 (VIN)
/+USBC_5V: C24.2, C56.1, D7.1 (K), TP41.1 (1_1), U7.6 (VIN2)
/CAN_H: D4.1 (CAN_H), IC1.7 (CANH), J6.2 (CAN_H), J7.2 (CAN_H), J11.2 (CAN_H), R9.1
/CAN_L: D4.2 (CAN_L), IC1.6 (CANL), J6.3 (CAN_L), J7.3 (CAN_L), J11.3 (CAN_L), JP1.2 (B)
/CAN_RX: IC1.4 (RXD), U1.26 (PB12)
/CAN_SHIELD: J7.5 (SHIELD), J11.5 (SHIELD), R61.1
/CAN_TX: IC1.1 (TXD), U1.27 (PB13)
/I2C_SCL: D5.3, J4.5, U1.39 (PA15)
/I2C_SDA: D5.1, J4.2, U1.46 (PB9)
/MUX_OUT: C58.1, D10.2 (A), TP42.1 (1_1), U7.2 (VOUT), U7.7 (VOUT__1)
/PowerProtection1/EN/UVLO: C54.1, IC3.1 (EN/UVLO), R28.2, R32.2
/PowerProtection1/OV: C53.1, IC3.7 (OV), R26.2, R27.1
/PowerProtection1/Vin: C48.1, D11.2 (A2), F2.2, JP3.1 (A), Q3.5, R24.2, R26.1, R28.1
/PowerProtection1/gate: IC3.6 (GATE), Q3.4, Q4.4, R25.2
/PowerProtection1/source: IC3.8 (SRC), Q3.1, Q3.2, Q3.3, Q4.1, Q4.2, Q4.3
/Power_Mux1/PR1: C57.1, R66.2, R67.1, U7.4 (PR1)
/SPI_MISO: J10.3, R42.2, U3.9 (DOUT/~DRDY)
/SPI_MOSI: J10.2, R41.2, U3.10 (DIN)
/SPI_SCK: J10.4, R48.2, U3.1 (SCLK)
/TC_ADC_CS: J10.1, R21.2, TP6.1 (1_1), U1.12 (PA4), U3.2 (~CS)
/Thermocouple/TC0+: D9.1, J8.2, R35.2, R39.1
/Thermocouple/TC0-: D9.3, J8.1, R37.1, R43.1
/Thermocouple/TC0N: C27.2, C31.1, R43.2, TP11.1 (1_1), U3.4 (AIN0)
/Thermocouple/TC0P: C27.1, C29.1, R39.2, TP8.1 (1_1), U3.5 (AIN1)
/Thermocouple/TC1+: D9.6, J5.1, R34.2, R38.1
/Thermocouple/TC1-: D9.4, J5.2, R36.1, R40.1
/Thermocouple/TC1N: C26.2, C30.1, R40.2, TP10.1 (1_1), U3.7 (AIN3)
/Thermocouple/TC1P: C26.1, C28.1, R38.2, TP7.1 (1_1), U3.6 (AIN2)
/USB-C_Connector/CC1: J3.A5 (CC1), R11.2
/USB-C_Connector/CC2: J3.B5 (CC2), R12.2
/USB-C_Connector/VBUS_IN: D6.4 (K), D7.2 (A), J3.A4 (VBUS), J3.A9 (VBUS), J3.B4 (VBUS), J3.B9 (VBUS)
GND: C1.1, C2.2, C4.2, C5.2, C6.2, C8.2, C10.2, C12.2, C13.2, C14.2, C16.2, C17.2, C18.2, C19.1, C23.2, C24.1, C25.2, C28.2, C29.2, C30.2, C31.2, C40.2, C41.2, C43.2, C44.2, C45.2, C46.1, C47.1, C48.2, C49.1, C51.2, C52.2, C53.2, C54.2, C55.2, C56.2, C57.2, C58.2, D2.1 (A1), D4.3 (GND), D5.2, D6.1 (A), D9.2, D11.1 (A1), D12.2 (A), D13.1 (K), D14.1 (K), D15.1 (K), FB1.2, IC1.2 (GND), IC1.8 (STB), IC3.2 (GND), J1.2, J2.2, J3.A1 (GND), J3.A12 (GND), J3.B1 (GND), J3.B12 (GND), J3.S1 (SHIELD), J3.S2 (Shield), J3.S3 (Shield), J3.S4 (Shield), J4.3, J6.4 (GND), J7.4 (GND), J10.5, J11.4 (GND), R1.2, R3.2, R4.2, R8.2, R11.1, R12.1, R23.2, R27.2, R32.1, R36.2, R37.2, R61.2, R67.2, SW1.2, SW2.3 (C), TP44.1 (1_1), TP45.1 (1_1), TP46.1 (1_1), U1.23 (VSS), U1.35 (VSS), U1.47 (VSS), U3.3 (GND), U5.4 (GND), U6.2 (GND), U7.1 (GND)
GNDA: C3.2, C7.2, C9.2, C11.2, C15.2, C59.2, FB1.1, U1.19 (VSSA)
unnamed: C19.2, R9.2, R10.1
unnamed: C51.1, R25.1
unnamed: D1.2, R1.1
unnamed: D1.4, R3.1
unnamed: D1.6, R4.1
unnamed: D2.2 (A2), D3.2 (A), R7.2, SW2.2 (B)
unnamed: D3.1 (K), R8.1
unnamed: C46.2, D10.1 (K), U6.1 (VI)
unnamed: C49.2, C50.1, D12.1 (K), IC3.5 (VS), R24.1
unnamed: D13.2 (A), R29.2
unnamed: D14.2 (A), R30.2
unnamed: D15.2 (A), R31.2
unnamed: C50.2, IC3.4 (VCAP)
unnamed: J1.3, J2.3, R5.2
unnamed: J1.4, J2.4, R6.2
unnamed: JP1.1 (A), R10.2
unnamed: C1.2, U1.5 (PF0-OSC_IN), Y1.1
unnamed: C2.1, U1.6 (PF1-OSC_OUT), Y1.2
unnamed: R33.2, U7.8 (ST)
