lhr-solar/VCAT-BlackBody/hardware/IrradianceBreakout/IrradianceBreakout.kicad_pcb

## KiCad design hardware/IrradianceBreakout/IrradianceBreakout.kicad_pcb (2026-11-08)

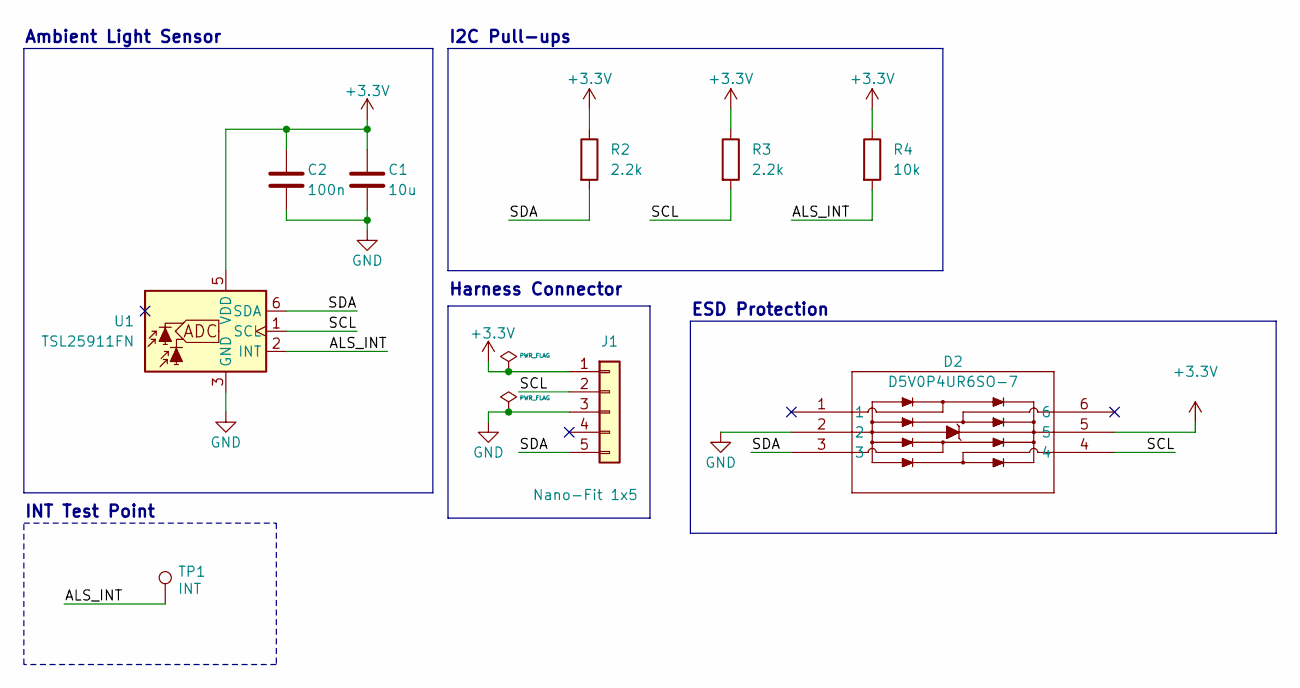
[picture p2: schematic IrradianceBreakout.kicad_sch]

Parts:
C1: 10u; C_0805_2012Metric_Pad1.18x1.45mm_HandSolder
C2: 100n; C_0603_1608Metric_Pad1.08x0.95mm_HandSolder
D2: D5V0P4UR6SO-7; Mouser Part Number 621-D5V0P4UR6SO-7
J1: Nano-Fit 1x5; Molex_Nano-Fit_105313-xx05_1x05_P2.50mm_Horizontal
R2, R3: 2.2k; R_0603_1608Metric_Pad0.98x0.95mm_HandSolder; LCSC P/N C4190
R4: 10k; R_0603_1608Metric_Pad0.98x0.95mm_HandSolder; LCSC P/N C25804
TP1: INT; TestPoint_Pad_D1.5mm
U1: TSL25911FN; AMS_TSL25911FN; LCSC P/N C176812

Connections:
+3.3V: C1.1, C2.1, D2.5, J1.1, R2.1, R3.1, R4.1, U1.5 (VDD)
/ALS_INT: R4.2, TP1.1, U1.2 (INT)
/SCL: D2.4, J1.2, R3.2, U1.1 (SCL)
/SDA: D2.3, J1.5, R2.2, U1.6 (SDA)
GND: C1.2, C2.2, D2.2, J1.3, U1.3 (GND)

Notes on the sheet:
INT Test Point
I2C Pull-ups
Ambient Light Sensor
ESD Protection
Harness Connector

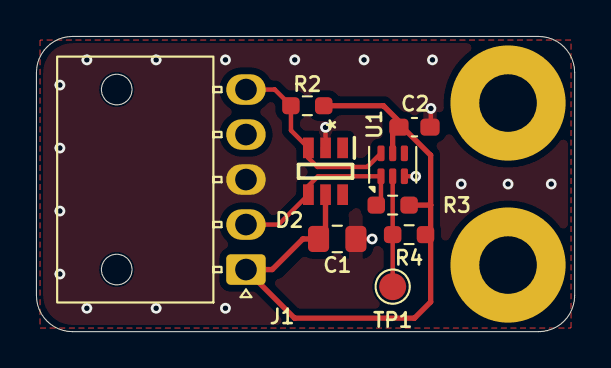
[picture p3: board IrradianceBreakout.kicad_pcb from above]

Board: 2 copper layers, 29.9 x 16.4 mm, 11 parts (0 on the bottom side), 5 nets.

Other parts of the board:
H1, H2: MountingHole_3.2mm_M3_Pad
