lhr-solar/VCAT-BlackBody/CubeMX/CubeMX.ioc

Mcu.UserName=STM32G473CETx
PA0.GPIO_Label=LED_B
PA0.Signal=S_TIM2_CH1
PA1.GPIO_Label=LED_R
PA1.Signal=S_TIM2_CH2
PA10.GPIO_Label=IRRAD_INT
PA10.Signal=GPXTI10
PA11.Signal=USB_DM
PA12.Signal=USB_DP
PA13.Signal=SYS_JTMS-SWDIO
PA14.Signal=SYS_JTCK-SWCLK
PA15.Signal=I2C1_SCL
PA2.GPIO_Label=LED_G
PA2.Signal=S_TIM2_CH3
PA4.GPIO_Label=TC_ADC_CS
PA4.Signal=GPIO_Output
PA5.Signal=SPI1_SCK
PA6.Signal=SPI1_MISO
PA7.Signal=SPI1_MOSI
PA8.GPIO_Label=STATUS_LED1
PA8.Signal=GPIO_Output
PB12.GPIO_Label=CAN_RX
PB12.Signal=FDCAN2_RX
PB13.GPIO_Label=CAN_TX
PB13.Signal=FDCAN2_TX
PB6.GPIO_Label=STATUS_LED2
PB6.Signal=GPIO_Output
PB7.GPIO_Label=STATUS_LED3
PB7.Signal=GPIO_Output
PB9.Signal=I2C1_SDA
PF0-OSC_IN.Signal=RCC_OSC_IN
PF1-OSC_OUT.Signal=RCC_OSC_OUT
