lhr-solar/VCAT-BlackBody/(commit log)

2026-10-06 Project setup: Main + Breakout KiCad projects, KiCAD-Sharepoint submodule, lib tables, PR template, README
2026-10-28 check breakout board layout
2026-10-30 Main board placement + silkscreen, breakout ground plane, DRC rule updates
    - Grouped placement and condensed outline (2 mm rounded corners)
    - Silkscreen refs moved next to their parts, pin labels added
    - Interrupt removed from main board and breakout (test point instead)
    - Breakout: B.Cu ground plane + stitching vias
    - Default clearance / hole clearance lowered to 0.15 mm
2026-11-08 BlackBody: main board placement, pin-header test points, breakout rebuild
    - Main board re-placed (power, MCU, CAN, USB, thermocouple and irradiance sections)
    - Test points switched to 1x01 pin headers
    - Irradiance breakout compact layout with SDA/SCL swap
    - Schematic updates for LDO, thermocouple and irradiance sheets
2026-11-10 ordered pcb
